ajahidny-crypto/self-watering-pot/self-Water-pot.stl

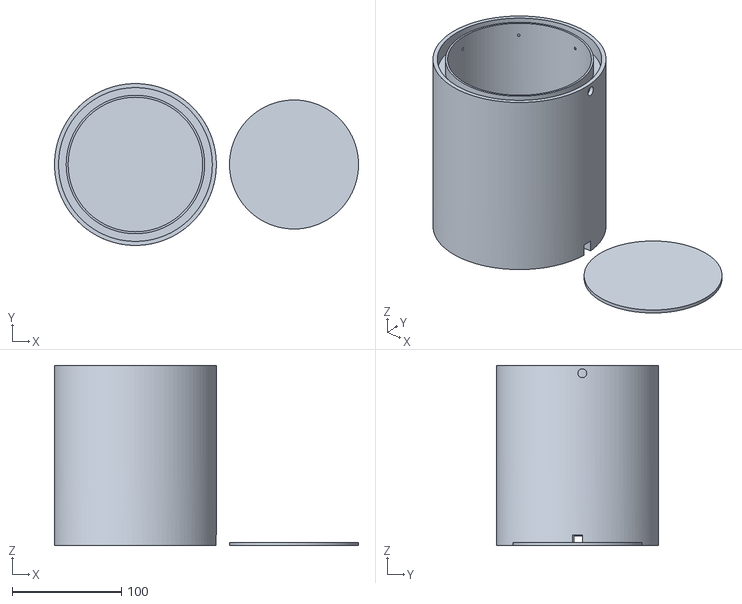
[picture p7: CAD file, 2026-10-30]
self-Water-pot.stl
278.0 x 148.0 x 165.0
